kevin8056/p3-motor-scooper/images/04-scoop-head-gear-train-open.jpg

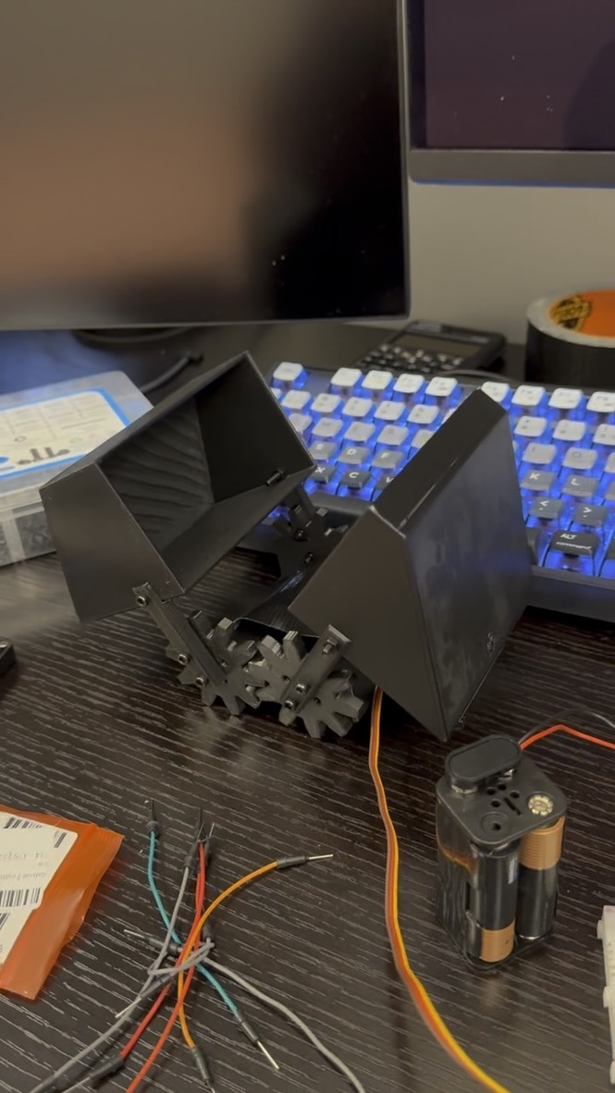
images/04-scoop-head-gear-train-open.jpg
