kevin8056/p3-motor-scooper/images/07-telescoping-shaft-extended.jpg

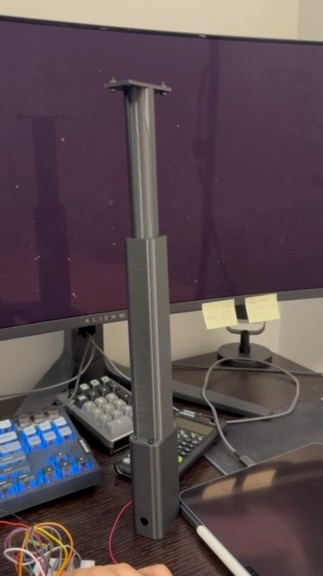
images/07-telescoping-shaft-extended.jpg
