kevin8056/p3-motor-scooper/images/09-telescoping-shaft-partial.jpg

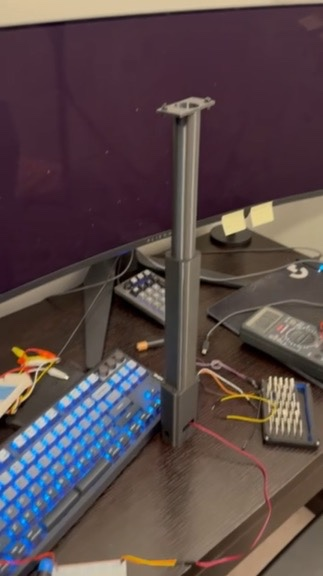
images/09-telescoping-shaft-partial.jpg
