kevin8056/p3-motor-scooper/images/20-breadboard-arduino-buttons.jpg

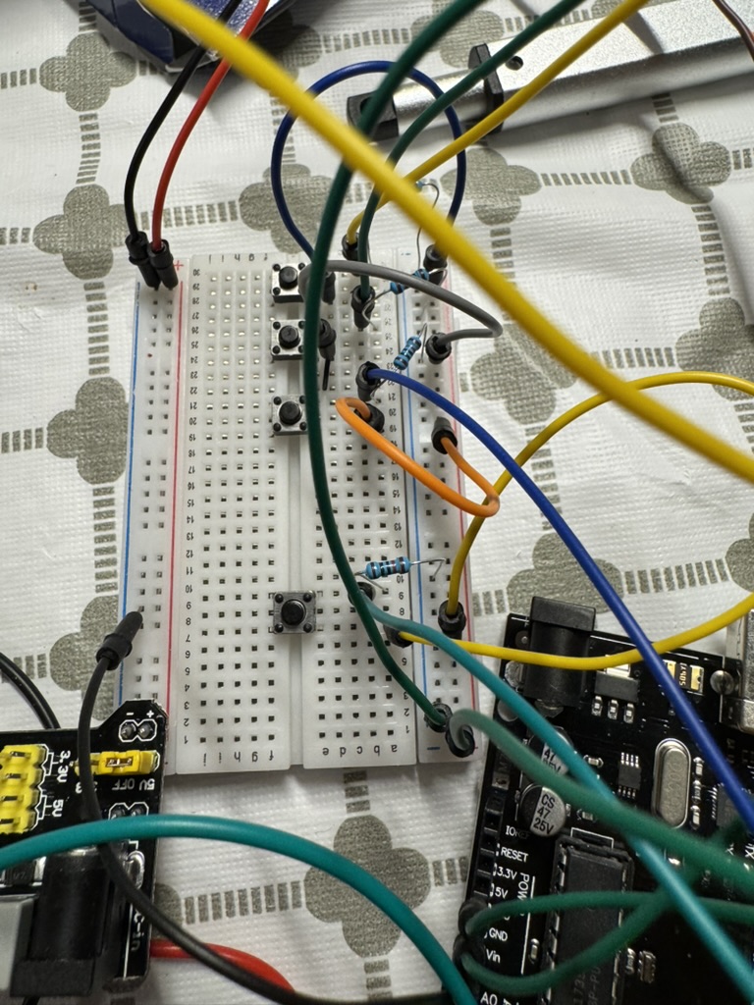
images/20-breadboard-arduino-buttons.jpg
