kevin8056/p3-motor-scooper/images/22-l298n-driver-mg995-servo.jpg

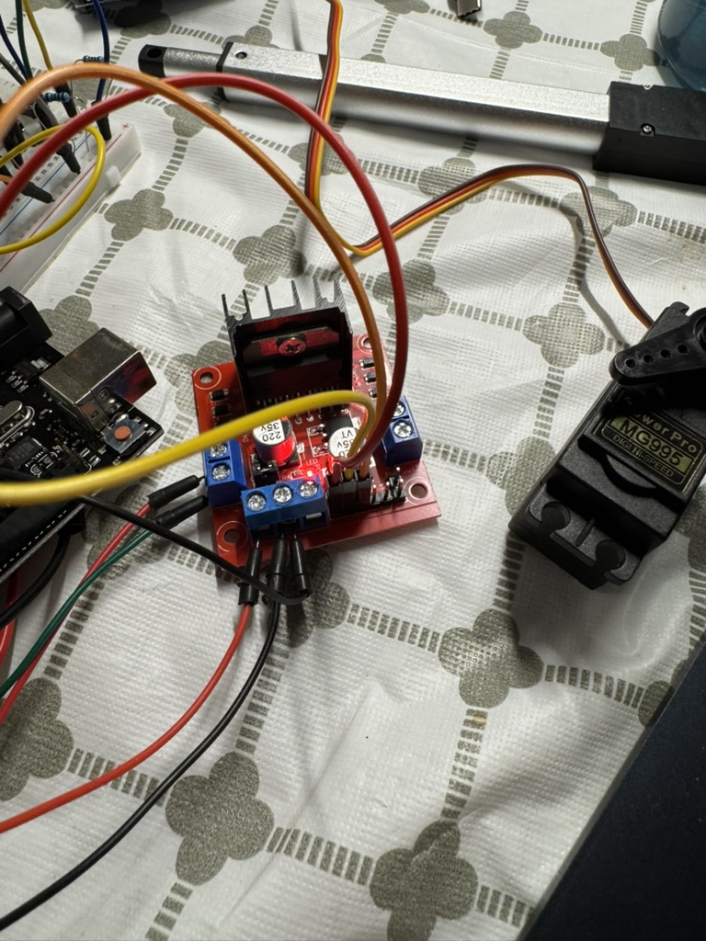
images/22-l298n-driver-mg995-servo.jpg
