kevin8056/p3-motor-scooper/images/23-feather-breadboard-9v-battery.jpg

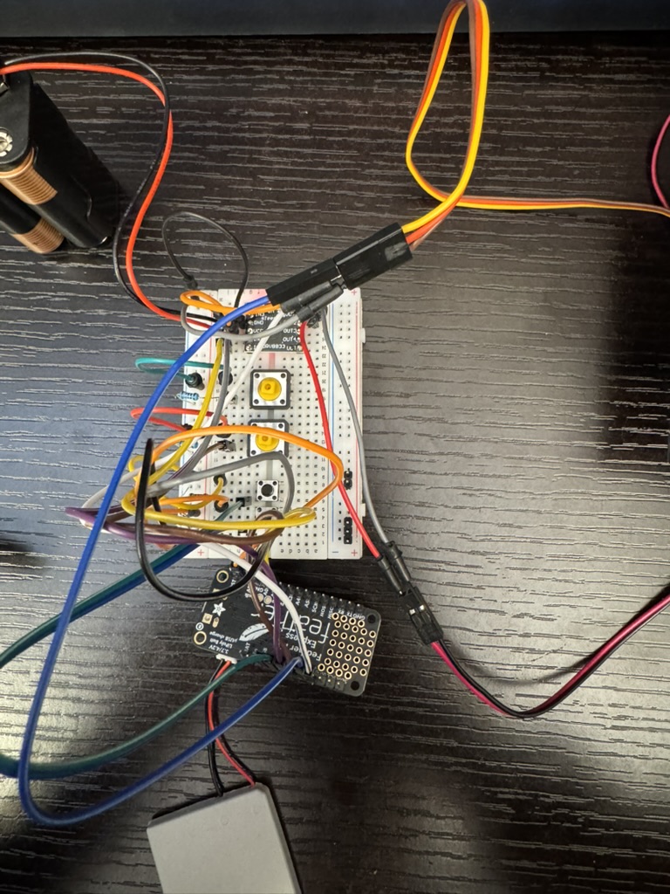
images/23-feather-breadboard-9v-battery.jpg
