kevin8056/p3-motor-scooper/images/26-pcb-button-board.jpg

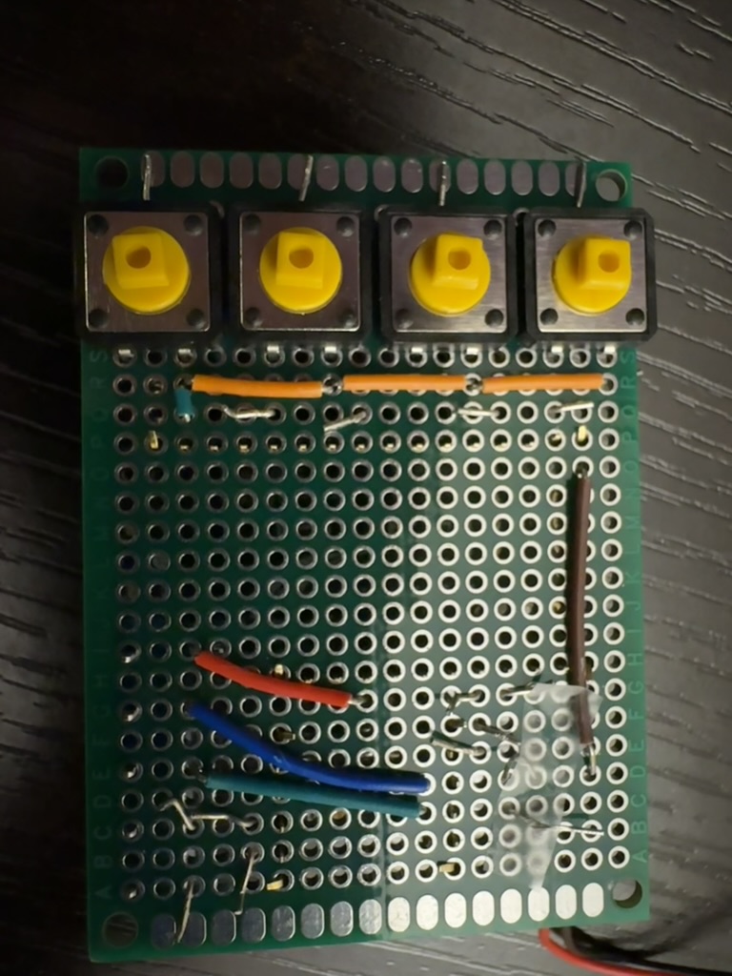
images/26-pcb-button-board.jpg
