kevin8056/p3-motor-scooper/images/33-pcb-with-tweezers-9v-clip.jpg

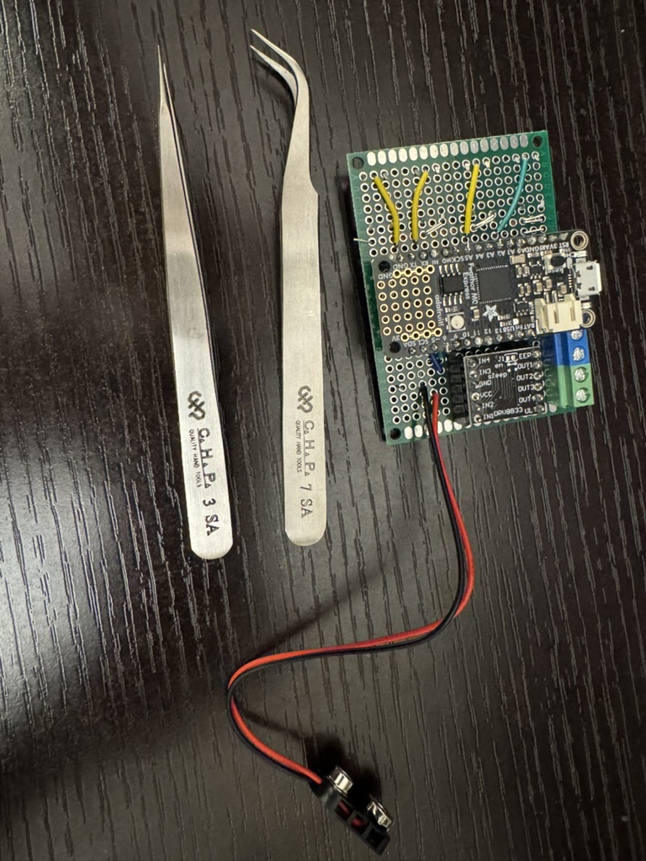
images/33-pcb-with-tweezers-9v-clip.jpg
