kevin8056/p3-motor-scooper/images/36-feather-adalogger-to-converter.jpg

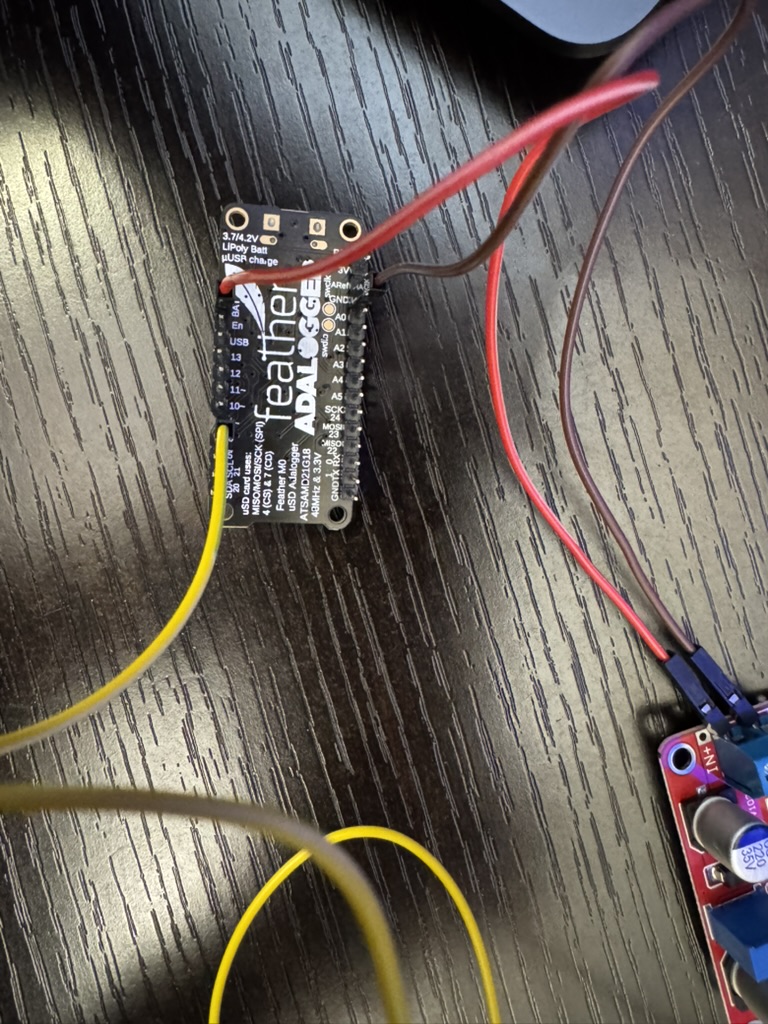
images/36-feather-adalogger-to-converter.jpg
