kevin8056/p3-motor-scooper/images/40-demo-picking-up-paper-from-chair.jpg

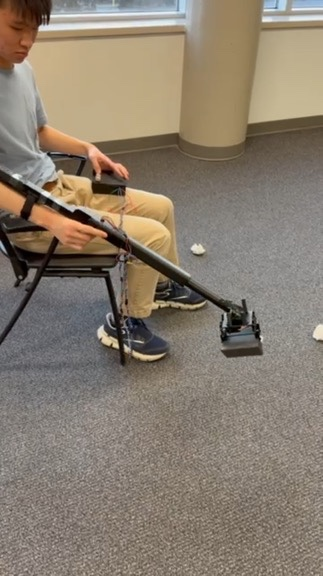
images/40-demo-picking-up-paper-from-chair.jpg
