kevin8056/p3-motor-scooper/images/06-scoop-head-servo-test-arduino.jpg

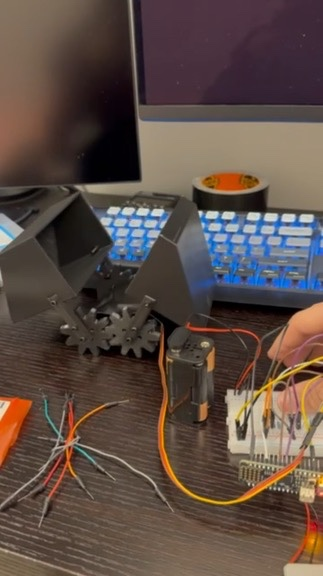
images/06-scoop-head-servo-test-arduino.jpg
