kevin8056/p3-motor-scooper/images/11-shaft-mounted-on-scoop-head-test.jpg

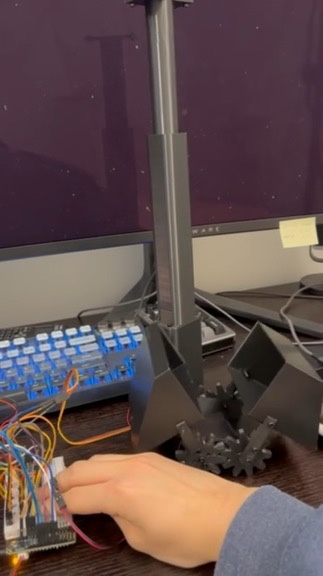
images/11-shaft-mounted-on-scoop-head-test.jpg
